mds5000/motor-driver/pcb/motor_driver.kicad_pcb

## KiCad design pcb/motor_driver.kicad_pcb (2025-06-19)

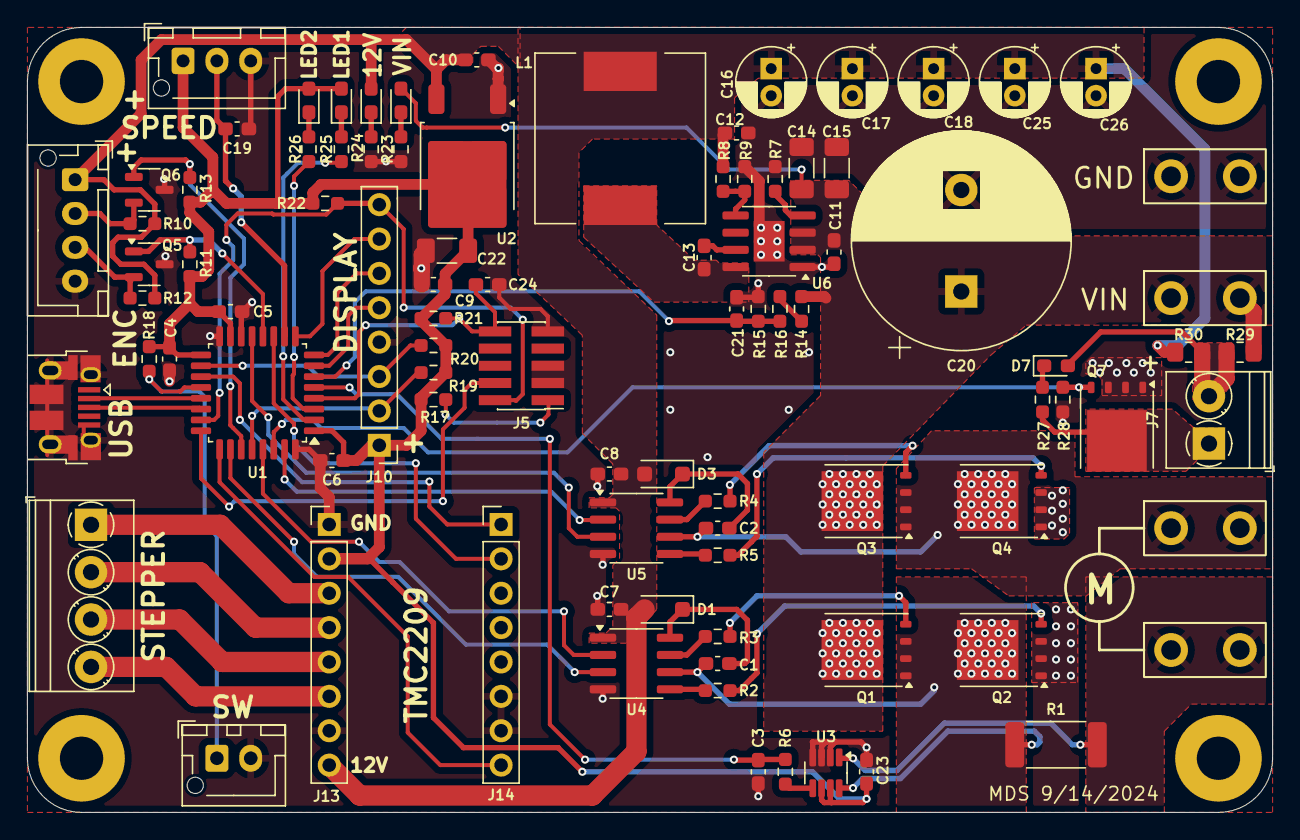
[picture p1: board motor_driver.kicad_pcb from above]

Board: 2 copper layers, 92.0 x 58.0 mm, 95 parts (0 on the bottom side), 63 nets.

Parts:
C1, C2, C3, C4, C5, C6, C7, C8, C9, C10, C11, C12, C13, C19, C21, C23, C24: 0.1uF; C_0603_1608Metric_Pad1.08x0.95mm_HandSolder
C14, C15: 1uF; C_1206_3216Metric_Pad1.33x1.80mm_HandSolder
C16, C17, C18, C25, C26: 10uF; CP_Radial_D5.0mm_P2.00mm
C20: 470uF; CP_Radial_D16.0mm_P7.50mm
C22: 4.7uF; C_1206_3216Metric_Pad1.33x1.80mm_HandSolder
D1, D3: 1N5819WS; D_SOD-123F
D2, D4, D5, D6, D7: LED; LED_0603_1608Metric_Pad1.05x0.95mm_HandSolder
H1, H2, H3, H4: MountingHole; MountingHole_3.2mm_M3_Pad
J1, J2, J3, J4: 1217861-1; CONN_QuickTab_TE_Conn_1217861-1
J5: Conn_ARM_JTAG_SWD_10; PinHeader_2x05_P1.27mm_Vertical_SMD
J6: Screw_Terminal_01x04; TerminalBlock_Phoenix_PT-1,5-4-3.5-H_1x04_P3.50mm_Horizontal
J7: Screw_Terminal_01x02; TerminalBlock_Phoenix_PT-1,5-2-3.5-H_1x02_P3.50mm_Horizontal
J8: Conn_01x03; JST_XH_B3B-XH-AM_1x03_P2.50mm_Vertical
J9: Conn_01x02; JST_XH_B2B-XH-AM_1x02_P2.50mm_Vertical
J10: Conn_01x08_Pin; PinHeader_1x08_P2.54mm_Vertical
J11: Conn_01x04; JST_XH_B4B-XH-AM_1x04_P2.50mm_Vertical
J12: USB_B_Micro; USB_Micro-B_Amphenol_10103594-0001LF_Horizontal
J13, J14: Conn_01x08_Socket; PinHeader_1x08_P2.54mm_Vertical
L1: 47uH; L_12x12mm_H8mm
Q1, Q2, Q3, Q4: BSC072N08NS5; TDSON-8-1
Q5, Q6: NPN; SOT-23-3
Q7: CSD17303Q5; TDSON-8-1
R1: 20mOhm; R_2512_6332Metric_Pad1.40x3.35mm_HandSolder
R2, R3, R4, R5, R6: 47; R_0603_1608Metric_Pad0.98x0.95mm_HandSolder
R7, R23, R27: 49.9K; R_0603_1608Metric_Pad0.98x0.95mm_HandSolder
R8, R14, R16: 110K; R_0603_1608Metric_Pad0.98x0.95mm_HandSolder
R9, R10, R11, R12, R13, R15, R18, R19, R20, R21, R22, R24, R28: 10K; R_0603_1608Metric_Pad0.98x0.95mm_HandSolder
R17: 220; R_0603_1608Metric_Pad0.98x0.95mm_HandSolder
R25, R26: 1K; R_0603_1608Metric_Pad0.98x0.95mm_HandSolder
R29: 0; R_0805_2012Metric_Pad1.20x1.40mm_HandSolder
R30: DNP; R_0805_2012Metric_Pad1.20x1.40mm_HandSolder
U1: STM32G431KBTx; LQFP-32_7x7mm_P0.8mm
U2: AZ1117-3.3; TO-252-2
U3: INA241A1xDDF; SOT-23-8
U4, U5: LM5109BMA; SOIC-8_3.9x4.9mm_P1.27mm
U6: SOIC-8-1EP_3.9x4.9mm_P1.27mm_EP2.29x3mm

Connections:
+3.3V: C4.1, C5.1, C6.1, C9.1, C22.1, C23.1, D5.2 (A), D6.2 (A), J8.1, J10.1, J13.2, R11.1, R13.1, R17.1, R18.2, R19.2, R20.2, R21.1, R22.1, U1.1 (VDD), U1.15 (VDDA), U1.17 (VDD), U2.2 (VO), U3.6 (V+), U3.7 (REF1)
+12V: C7.1, C8.1, C10.1, C12.1, C16.1, C17.1, C18.1, C25.1, C26.1, D1.2 (A), D3.2 (A), D4.2 (A), J11.1, J13.8, L1.2, R8.2, R10.1, R12.1, R30.2, U2.3 (VI), U4.1 (VDD), U5.1 (VDD)
/BTN_ENT: J5.2 (SWDIO/TMS), J10.8, R22.2, U1.23 (PA13)
/DIR: J14.1, U1.19 (PA9)
/DISP_CLK: J10.3, R20.1, U1.18 (PA8)
/DISP_DAT: J10.2, R19.1, U1.28 (PB5)
/ENABLE: J14.8, U1.25 (PA15)
/ENC_A: J10.5, U1.7 (PA2)
/ENC_B: J10.6, U1.8 (PA3)
/ENC_BTN: J10.7, U1.9 (PA4)
/ISNS: C3.1, R6.2, U1.5 (PA0)
/LED1: R25.1, U1.2 (PF0)
/LED2: R26.1, U1.3 (PF1)
/MTR_A: C1.2, Q1.1 (S), Q1.2 (S), Q1.3 (S), Q2.5 (D), R1.1, U3.8 (+), U4.6 (HS)
/MTR_A_R: J1.1, J1.2, R1.2, U3.1 (-)
/MTR_B: C2.2, J2.1, J2.2, Q3.1 (S), Q3.2 (S), Q3.3 (S), Q4.5 (D), U5.6 (HS)
/NRST: C24.1, J5.10 (~RESET), R21.2, U1.4 (PG10)
/ON_SW: J9.1, R18.1, U1.20 (PA10)
/OVERVOLT: Q7.4 (G), R28.1, U1.30 (PB7)
/PHASE_A: Q6.1 (C), R13.2, U1.27 (PB4)
/PHASE_B: Q5.1 (C), R11.2, U1.12 (PA7)
/SPEED: C19.2, J8.2, U1.10 (PA5)
/STEP: J14.2, U1.11 (PA6)
/SWA_HS: U1.29 (PB6), U4.2 (HI)
/SWA_LS: U1.26 (PB3), U4.3 (LI)
/SWB_HS: U1.31 (PB8), U5.2 (HI)
/SWB_LS: U1.13 (PB0), U5.3 (LI)
/SWCLK: J5.4 (SWCLK/TCK), U1.24 (PA14)
/USB_DN: J12.2 (D-), U1.21 (PA11)
/USB_DP: J12.3 (D+), U1.22 (PA12)
/VIN: C11.1, C14.1, C15.1, C20.1, D2.2 (A), J3.1, J3.2, Q1.5 (D), Q3.5 (D), R14.2, R29.2, U6.2 (EN), U6.3 (VIN)
/VSNS: C21.1, R15.2, R16.1, U1.6 (PA1)
GND: C3.2, C4.2, C5.2, C6.2, C7.2, C8.2, C9.2, C10.2, C11.2, C12.2, C14.2, C15.2, C16.2, C17.2, C18.2, C19.1, C20.2, C21.2, C22.2, C23.2, C24.2, C25.2, C26.2, J4.1, J4.2, J5.3 (GND), J5.5 (GND), J5.9 (GNDDetect), J8.3, J9.2, J10.4, J11.4, J12.5 (GND), J12.6 (Shield), J13.1, J13.7, J14.6, J14.7, Q2.1 (S), Q2.2 (S), Q2.3 (S), Q4.1 (S), Q4.2 (S), Q4.3 (S), Q5.3 (E), Q6.3 (E), Q7.1 (S), Q7.2 (S), Q7.3 (S), R7.1, R9.1, R15.1, R23.1, R24.1, R28.2, U1.14 (VSSA), U1.16 (VSS), U1.32 (VSS), U2.1 (GND), U3.2 (GND), U3.3 (REF2), U3.4 (GND), U4.4 (VSS), U5.4 (VSS), U6.1 (GND), U6.9 (EP)
unnamed: C1.1, D1.1 (K), U4.8 (HB)
unnamed: D2.1 (K), R23.2
unnamed: C2.1, D3.1 (K), U5.8 (HB)
unnamed: D4.1 (K), R24.2
unnamed: D5.1 (K), R25.2
unnamed: D6.1 (K), R26.2
unnamed: D7.2 (A), J7.2, R29.1, R30.1
unnamed: D7.1 (K), R27.2
unnamed: J5.1 (VTref), R17.2
unnamed: J7.1, Q7.5 (D), R27.1
unnamed: J11.2, Q6.2 (B), R10.2
unnamed: J11.3, Q5.2 (B), R12.2
unnamed: J6.1, J13.3
unnamed: J6.2, J13.4
unnamed: J6.3, J13.5
unnamed: J6.4, J13.6
unnamed: Q1.4 (G), R3.2
unnamed: Q2.4 (G), R2.2
unnamed: Q3.4 (G), R4.1
unnamed: Q4.4 (G), R5.1
unnamed: R6.1, U3.5
unnamed: R14.1, R16.2
unnamed: R3.1, U4.7 (HO)
unnamed: R2.1, U4.5 (LO)
unnamed: R4.2, U5.7 (HO)
unnamed: R5.2, U5.5 (LO)
unnamed: C13.1, U6.7 (BOOT)
unnamed: R8.1, R9.2, U6.5 (FB)
unnamed: R7.2, U6.4 (RT/SYNC)
unnamed: C13.2, L1.1, U6.8 (SW)
