mds5000/motor-driver/(commit log)

2024-09-29 Switched to RTIC runtime
2024-10-20 Torque and Speed control PID tuned.
2024-12-11 Implemented homing routine
2025-06-19 Update motor driver fw
2025-06-19 Added PCB
    [motor_driver.kicad_pcb, motor_driver.kicad_sch]
2025-06-19 Pin HAL version
